rabbits-robotics/gamma_chassis_pcb/docs/2026-10-18-v1.0-jumper.md

# v1.0 の未配線とジャンパ対応

- 日付: 2026-10-18
- 対象: v1.0（2026-08-10 発注）

## 事象

CAN_TURRET1 のピン 1（CAN_CHASSIS1 ピン 1 と同じネット）に B.Cu の配線が届いておらず、未接続のまま発注した。DRC（KiCad 8.0.7、`unconnected_items`）で 1 件として検出される。

## 対応

実装時にジャンパ線で接続した（v1.0 の実物はこの状態で使う）。

## 次の改版で

- CAN_TURRET1 ピン 1 までの配線を引き直し、DRC の未接続 0 件を確認してから発注する
- あわせて、サーマルリリーフ不足とシルクの警告も確認する
