rabbits-robotics/gamma_chassis_pcb/bom.csv

Reference | Value | Footprint | QUANTITY
CAN_CHASSIS1-CAN_CHASSIS4,CAN_LEG1-CAN_LEG4,CAN_TURRET1 | Conn_01x02 | Connector_JST:JST_PH_B2B-PH-K_1x02_P2.00mm_Vertical | 9
Power1-Power8 | Conn_01x02 | Connector_AMASS:AMASS_XT30U-F_1x02_P5.0mm_Vertical | 8
Vin1 | Conn_01x02 | Connector_AMASS:AMASS_XT30PW-M_1x02_P2.50mm_Horizontal | 1
Vout1 | Conn_01x06 | Connector_JST:JST_PH_B6B-PH-K_1x06_P2.00mm_Vertical | 1
