rabbits-robotics/gamma_chassis_pcb/gamma_chassis.step

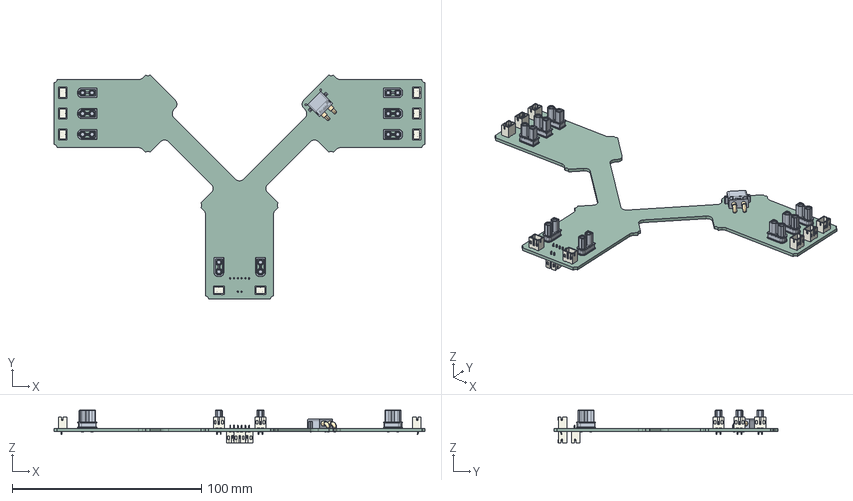
[picture p1: CAD file, 2026-10-18]
gamma_chassis.step
196.0 x 118.4 x 17.3 mm
ASSEMBLY x 8
JST_B2B_PH_K x 9
CONN-TH_XT30PW-M
JST_B6B_PH_K
gamma_chassis_PCB
