rabbits-robotics/gamma_chassis_pcb/(list of files, cad)

Other CAD files:
gamma_chassis.DXF
