rabbits-robotics/gamma_chassis_pcb/gamma_chassis.pdf

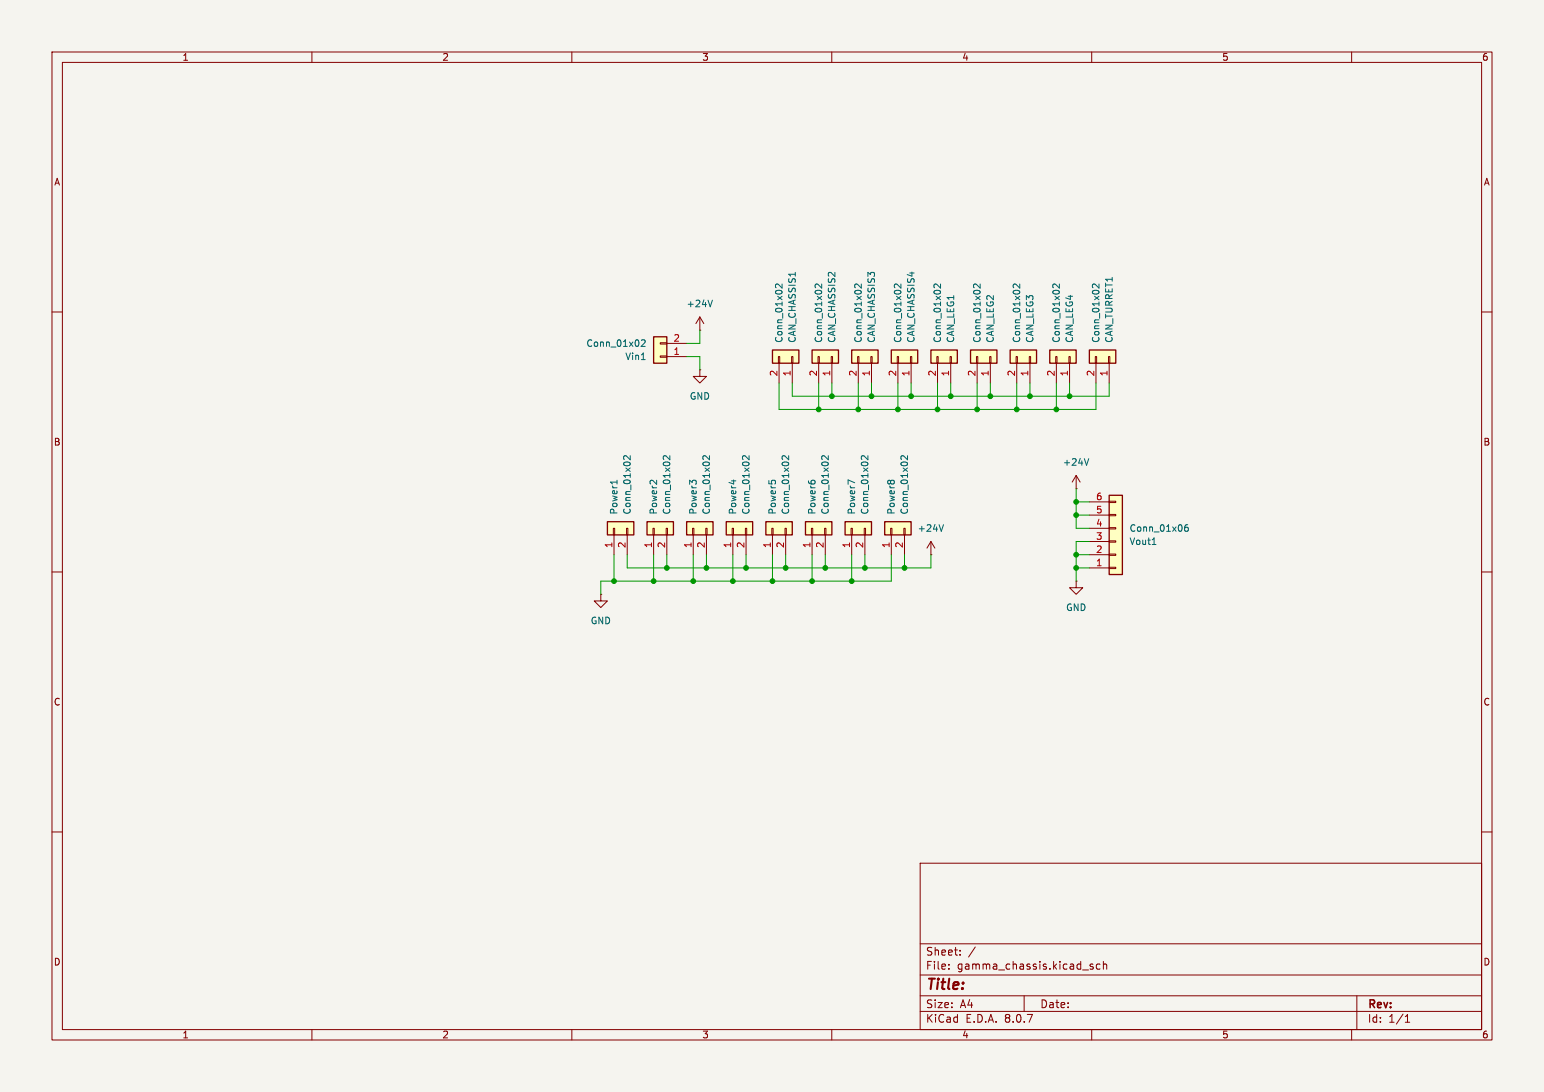
[picture p2: page 1]
