rabbits-robotics/gamma_chassis_pcb/gamma_chassis.kicad_pcb

## KiCad design gamma_chassis.kicad_pcb (2026-10-18)

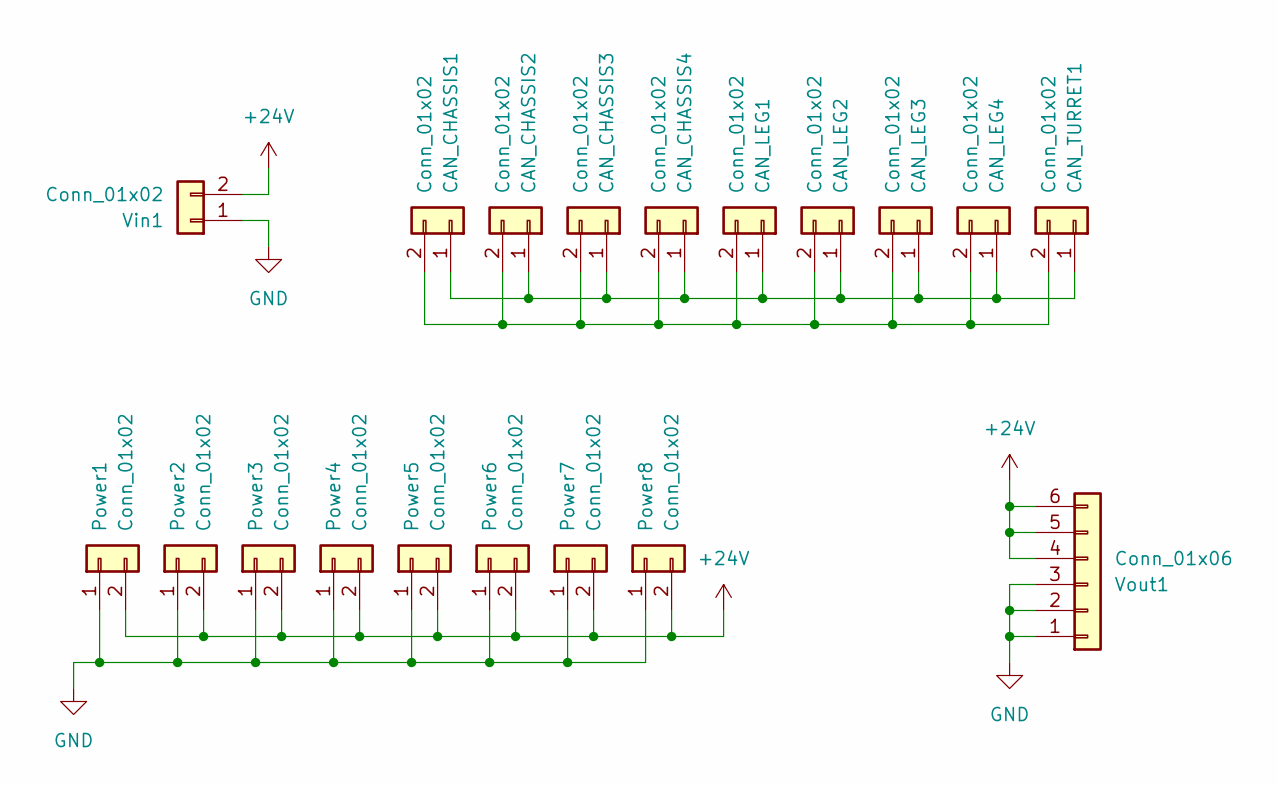
[picture p3: schematic gamma_chassis.kicad_sch]

Parts:
CAN_CHASSIS1, CAN_CHASSIS2, CAN_CHASSIS3, CAN_CHASSIS4: Conn_01x02; JST_PH_B2B-PH-K_1x02_P2.00mm_Vertical
CAN_LEG1, CAN_LEG2, CAN_LEG3, CAN_LEG4: Conn_01x02; JST_PH_B2B-PH-K_1x02_P2.00mm_Vertical
CAN_TURRET1: Conn_01x02; JST_PH_B2B-PH-K_1x02_P2.00mm_Vertical
Power1, Power2, Power3, Power4, Power5, Power6, Power7, Power8: Conn_01x02; AMASS_XT30U-F_1x02_P5.0mm_Vertical
Vin1: Conn_01x02; AMASS_XT30PW-M_1x02_P2.50mm_Horizontal
Vout1: Conn_01x06; JST_PH_B6B-PH-K_1x06_P2.00mm_Vertical

Connections:
+24V: Power1.2, Power2.2, Power3.2, Power4.2, Power5.2, Power6.2, Power7.2, Power8.2, Vin1.2, Vout1.4, Vout1.5, Vout1.6
GND: Power1.1, Power2.1, Power3.1, Power4.1, Power5.1, Power6.1, Power7.1, Power8.1, Vin1.1, Vout1.1, Vout1.2, Vout1.3
unnamed: CAN_CHASSIS1.1, CAN_CHASSIS2.1, CAN_CHASSIS3.1, CAN_CHASSIS4.1, CAN_LEG1.1, CAN_LEG2.1, CAN_LEG3.1, CAN_LEG4.1, CAN_TURRET1.1
unnamed: CAN_CHASSIS1.2, CAN_CHASSIS2.2, CAN_CHASSIS3.2, CAN_CHASSIS4.2, CAN_LEG1.2, CAN_LEG2.2, CAN_LEG3.2, CAN_LEG4.2, CAN_TURRET1.2

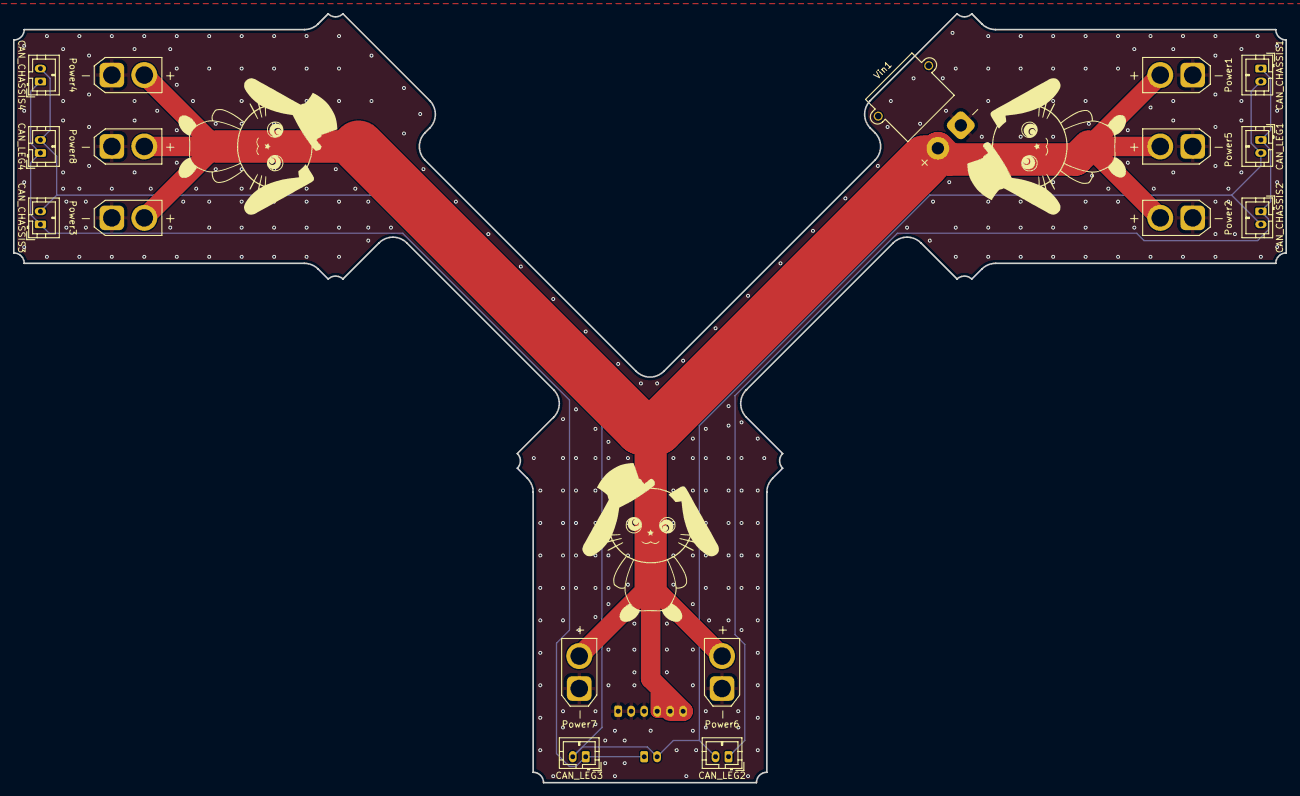
[picture p4: board gamma_chassis.kicad_pcb from above]

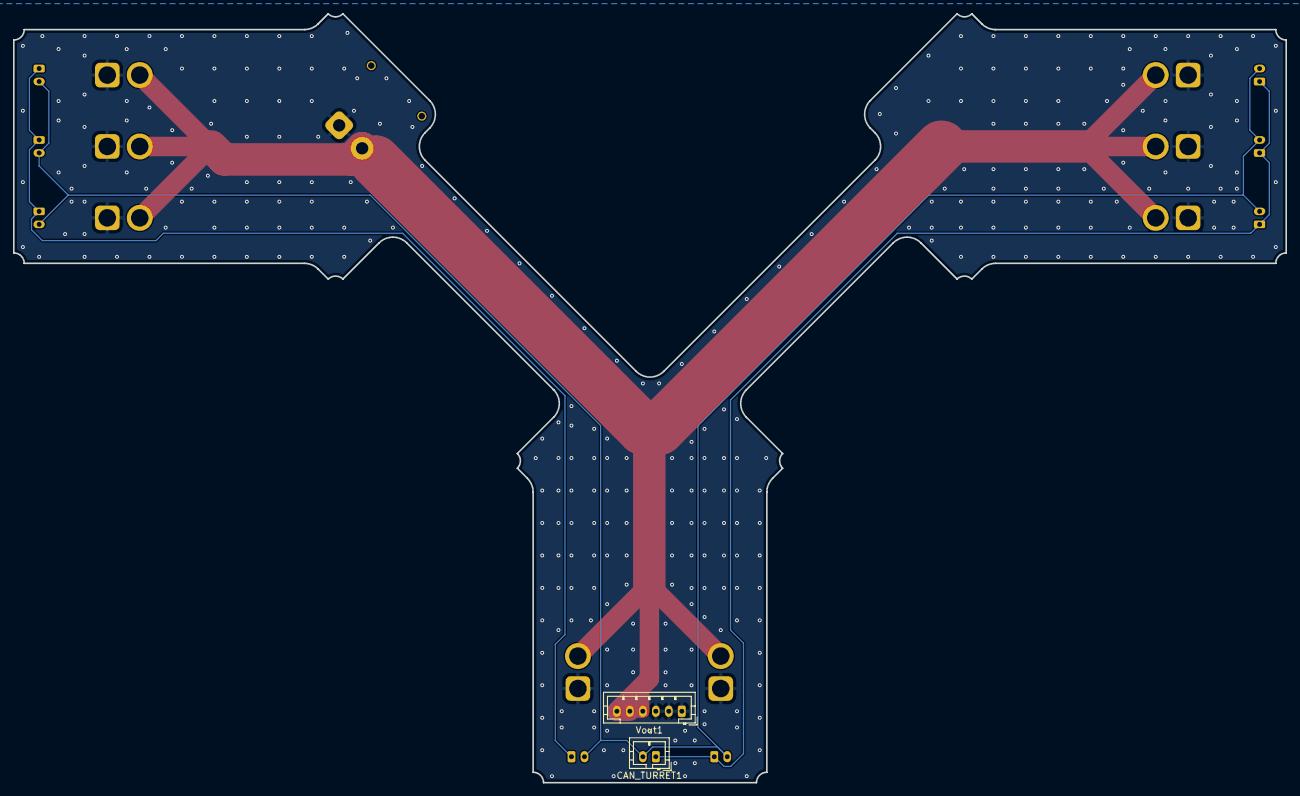
[picture p5: board gamma_chassis.kicad_pcb from below]

Board: 2 copper layers, 196.0 x 118.4 mm, 19 parts (2 on the bottom side), 4 nets.
