rabbits-robotics/gamma_chassis_pcb/(commit log)

2026-10-18 KiCad プロジェクトを追加（2026-08-10 発注版）
    [bom.csv, gamma_chassis.DXF, gamma_chassis.kicad_pcb, gamma_chassis.kicad_sch, gamma_chassis.step]
2026-10-18 v1.0 の未配線とジャンパ対応を記録
